dilshan/6ch-speaker-selector/readme.md

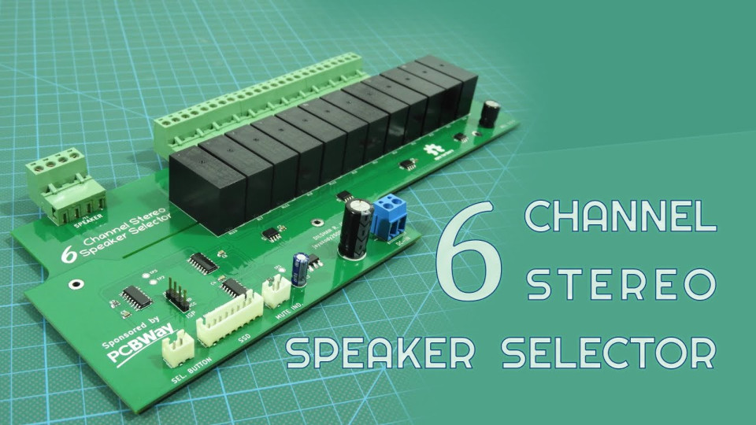
[picture p1: resources/6ch-speaker-selector-youtube.jpg]
6-channel-speaker-selector video (https://youtu.be/IV8KEQPGEuk)


This project is a DIY six-channel stereo speaker selector based on *[STC15W201](https://www.stcmicro.com/datasheet/STC15W201S_Features.pdf)* MCU. The purpose of this electronic switch is to share a pair of speakers between six stereo audio systems.

To select each speaker channel, we use a couple of 12V DPDT relays. These relays interface to *74HC595* through a *ULN2001D*, 3-channel Darlington transistor array IC. 

The 6-channel speaker selector is an open-source project. This repository has all the schematics, PCB design files, and firmware source codes. 

The complete [documentation](https://github.com/dilshan/6ch-speaker-selector/wiki) of this project is in the [wiki section](https://github.com/dilshan/6ch-speaker-selector/wiki) of this repository. The PCB Gerber files and compiled binaries are also available in the [release section](https://github.com/dilshan/6ch-speaker-selector/releases) of this repository. The PCB of the 6-channel speaker selector can also order from the [PCBWay website](https://www.pcbway.com/project/shareproject/6_channel_stereo_speaker_selector_a32e4deb.html).

This is a [certified open hardware project](https://certification.oshwa.org/lk000013.html) and all the content of this project is distributed under the terms of the following license:

- Hardware License: [CERN-OHL-W 2.0](https://ohwr.org/cern_ohl_w_v2.txt)
- Software License: [MIT](https://github.com/dilshan/6ch-speaker-selector/blob/main/LICENSE)
- [Documentation](https://github.com/dilshan/6ch-speaker-selector/wiki) License: [CC BY 4.0](https://creativecommons.org/licenses/by/4.0/)
