dilshan/6ch-speaker-selector/design/speaker-selector-v2.ods

Ref | Qnty | Value | Cmp name | Footprint | Description | Vendor
C1, | 1 | 470MFD | C_Polarized_US | Capacitor_THT:CP_Radial_D10.0mm_P5.00mm | Polarized capacitor, US symbol
C2, | 1 | 10MFD | C_Polarized_US | Capacitor_THT:CP_Radial_D5.0mm_P2.00mm | Polarized capacitor, US symbol
C3, | 1 | 0.22MFD | C | Capacitor_SMD:C_0805_2012Metric_Pad1.18x1.45mm_HandSolder | Unpolarized capacitor
C4, C5, C6, C7, C9, | 5 | 0.1MFD | C | Capacitor_SMD:C_0805_2012Metric_Pad1.18x1.45mm_HandSolder | Unpolarized capacitor
C8, | 1 | 100MFD | C_Polarized_US | Capacitor_THT:CP_Radial_D6.3mm_P2.50mm | Polarized capacitor, US symbol
H1, H2, H3, H4, | 4 | M3 | MountingHole_Pad | MountingHole:MountingHole_2.5mm_Pad | Mounting Hole with connection
H5, | 1 | LOGO | MountingHole | LOGO:6ch-sss | Mounting Hole without connection
H6, | 1 | LOGO | MountingHole | LOGO:pcbway | Mounting Hole without connection
H7, | 1 | LOGO | MountingHole | Symbol:OSHW-Logo2_14.6x12mm_SilkScreen | Mounting Hole without connection
H8, | 1 | LOGO | MountingHole | LOGO:6ch-sss-large | Mounting Hole without connection
J1, | 1 | 5mm x 2-pin | Conn_01x02 | TerminalBlock_Phoenix:TerminalBlock_Phoenix_MKDS-1,5-2_1x02_P5.00mm_Horizontal | Generic connector, single row, 01x02, script generated (kicad-library-utils/schlib/autogen/connector/)
J2, J4, | 2 | 2.54mm x 2-pin | Conn_01x02 | Connector_JST:JST_EH_B2B-EH-A_1x02_P2.50mm_Vertical | Generic connector, single row, 01x02, script generated (kicad-library-utils/schlib/autogen/connector/)
J3, | 1 | 2.54mm x 8-pin | Conn_01x08 | Connector_JST:JST_EH_B8B-EH-A_1x08_P2.50mm_Vertical | Generic connector, single row, 01x08, script generated (kicad-library-utils/schlib/autogen/connector/)
J5, J6, J7, J8, J9, J10, J11, | 7 | 5mm x 4-pin | Conn_01x04 | Connector_Phoenix_MC_HighVoltage:PhoenixContact_MC_1,5_4-G-5.08_1x04_P5.08mm_Horizontal | Generic connector, single row, 01x04, script generated (kicad-library-utils/schlib/autogen/connector/)
J12, | 1 | 2.54mm-4-pin-PCB-PAD | Conn_01x04 | Connector_PinHeader_2.54mm:PinHeader_1x04_P2.54mm_Vertical | Generic connector, single row, 01x04, script generated (kicad-library-utils/schlib/autogen/connector/)
R1, | 1 | 10K | R | Resistor_SMD:R_0805_2012Metric_Pad1.20x1.40mm_HandSolder | Resistor
R2, | 1 | 22K | R | Resistor_SMD:R_0805_2012Metric_Pad1.20x1.40mm_HandSolder | Resistor
RL1, RL2, RL3, RL4, RL5, RL6, RL7, RL8, RL9, RL10, RL11, RL12, | 12 | G2RL-2-DC12 | G2RL-2-DC12 | Relay_THT:Relay_DPDT_Omron_G2RL | General Purpose Relay DPDT (2 Form C) Through Hole, Omron G2RL series, 12V coil
RN1, RN2, | 2 | 620R | R_Pack04_Split | Resistor_SMD:R_Array_Concave_4x0603 | 4 resistor network, parallel topology, split
TP1, TP2, TP3, | 3 | SMD-TP | TestPoint | TestPoint:TestPoint_Pad_D2.0mm | test point
U1, | 1 | LM1117-5.0 | LM1117-5.0 | Package_TO_SOT_SMD:SOT-223-3_TabPin2 | 800mA Low-Dropout Linear Regulator, 5.0V fixed output, TO-220/TO-252/TO-263/SOT-223
U2, | 1 | STC15W201S | STC15W201S | Package_SO:SOP-16_3.9x9.9mm_P1.27mm | Enhanced 8051 MCU
U3, U4, | 2 | 74AHC595 | 74AHC595 | Package_SO:SOP-16_3.9x9.9mm_P1.27mm | 8-bit serial in/out Shift Register 3-State Outputs
U5, U6, U7, U8, | 4 | ULN2001D | ULN2001D | Package_SO:SOP-8_3.9x4.9mm_P1.27mm | 3-CH DARLINGTON SINK DRIVER
