dilshan/6ch-speaker-selector/resources/6ch-speaker-selector-schematic.pdf

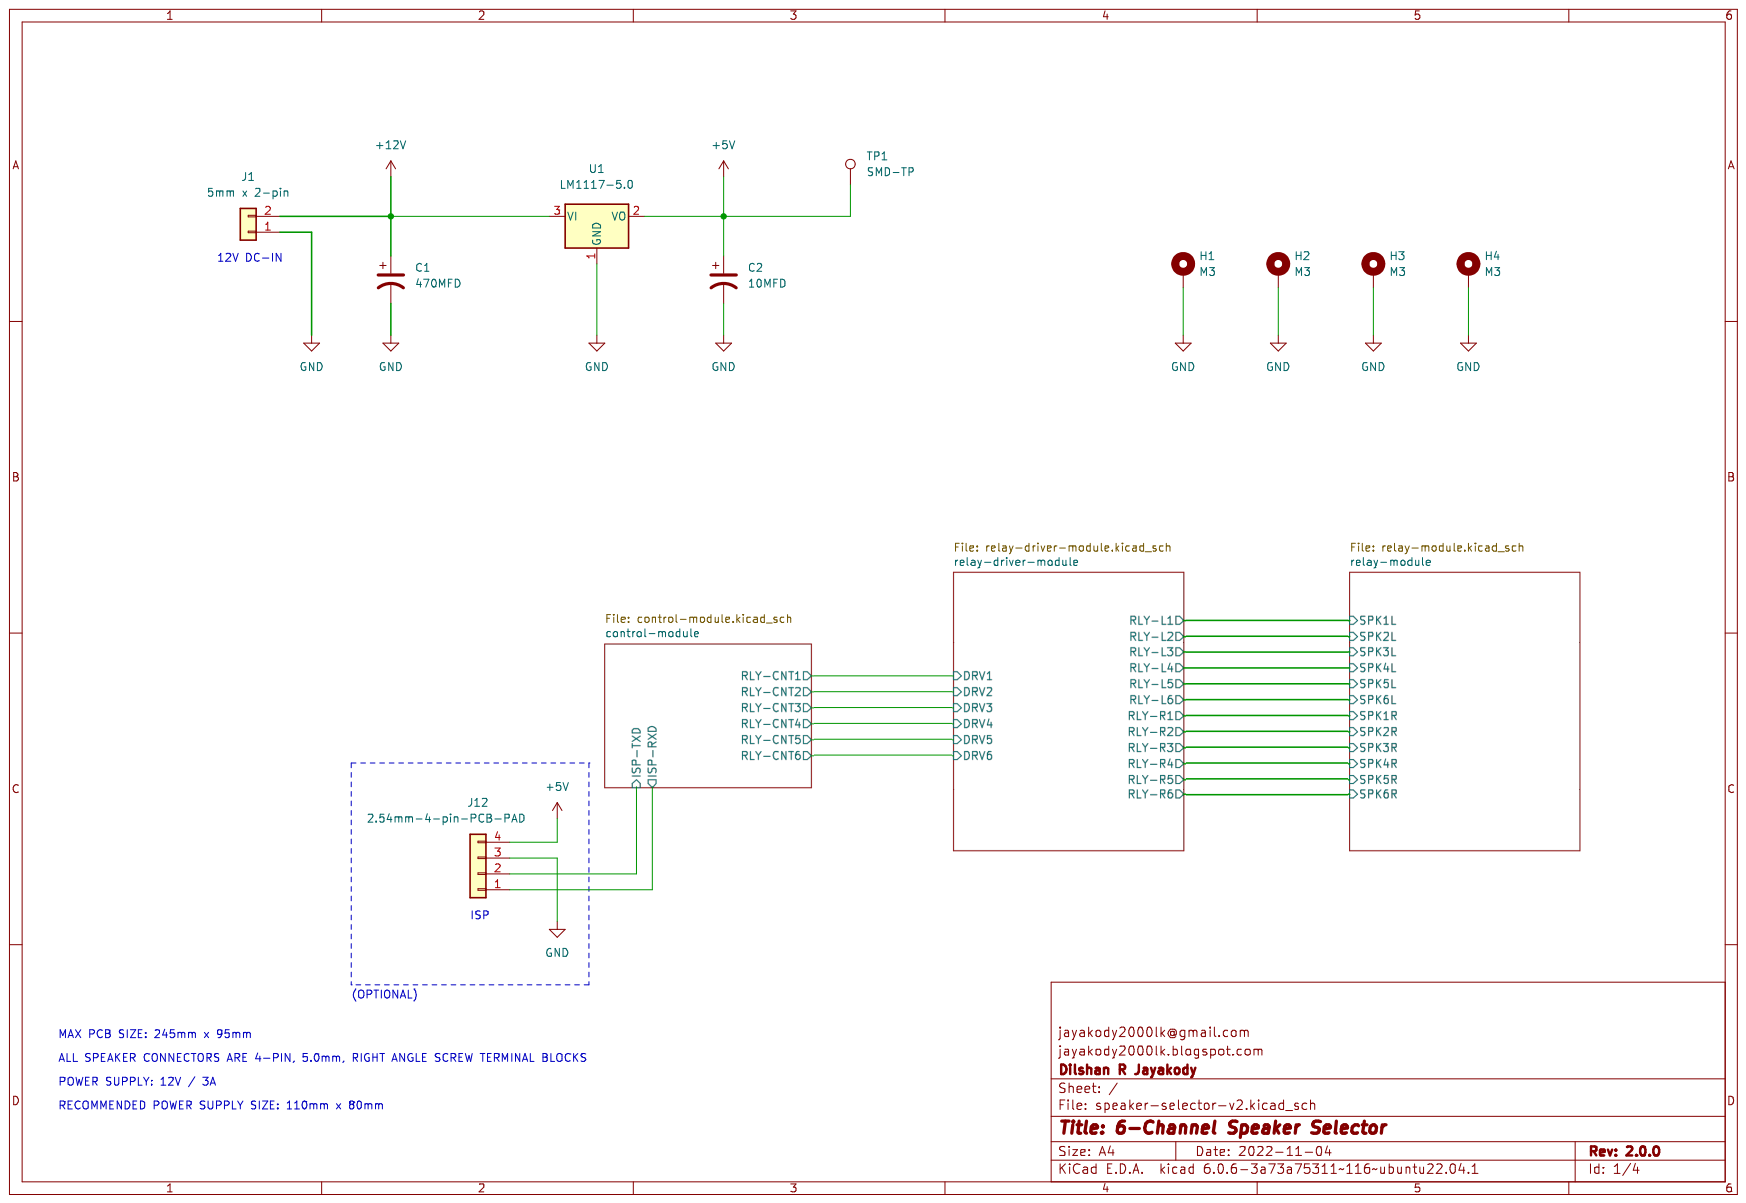
[picture p2: page 1]

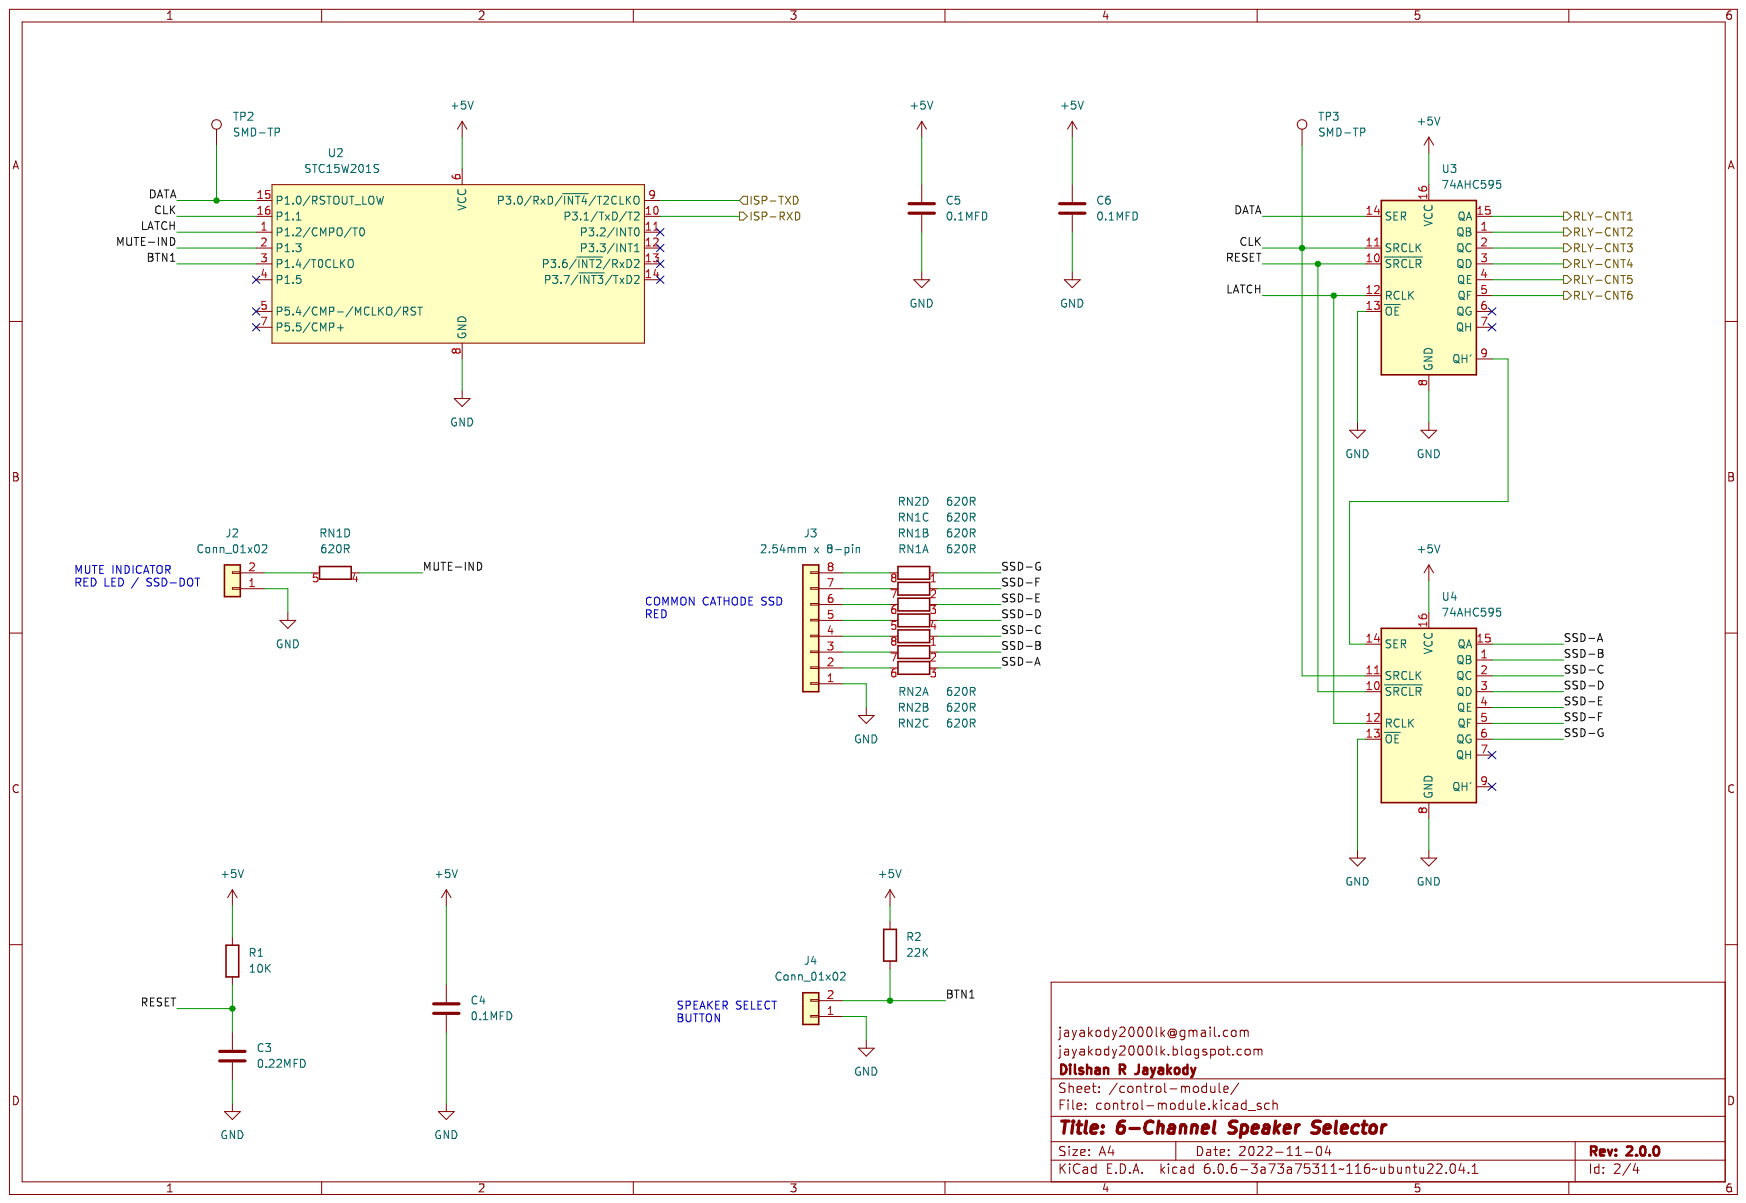
[picture p3: page 2]

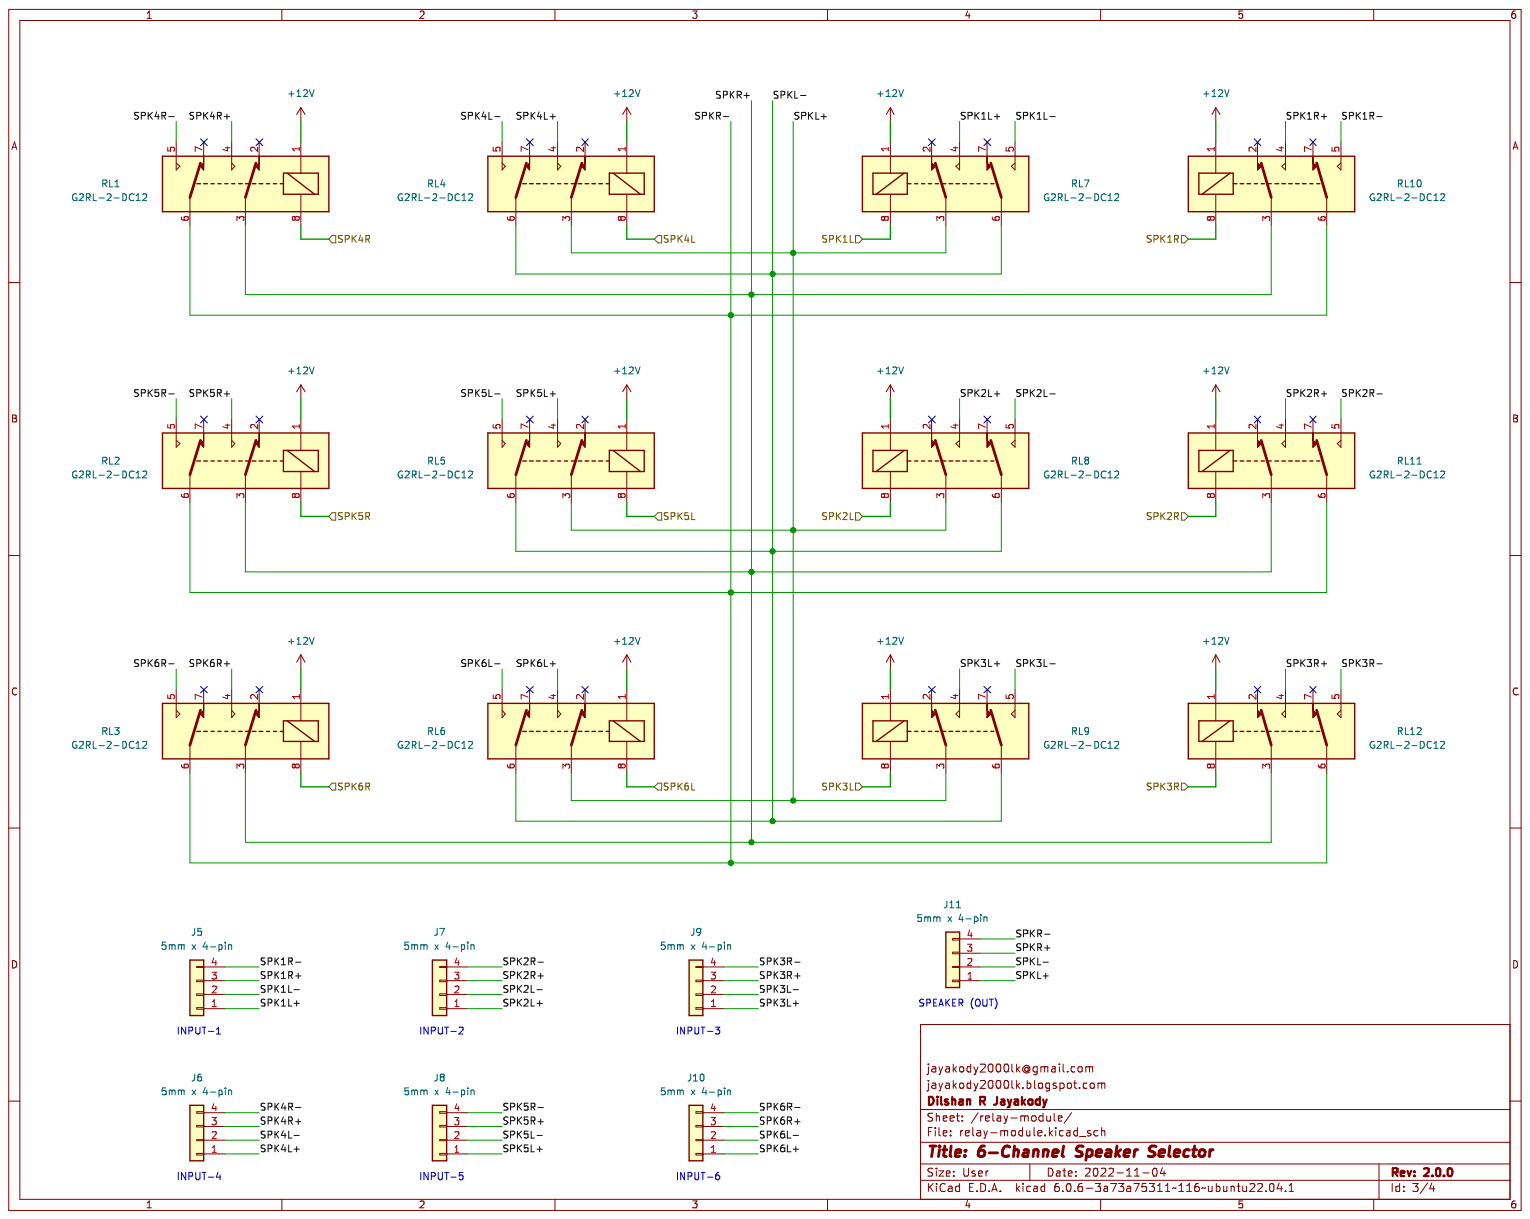
[picture p4: page 3]

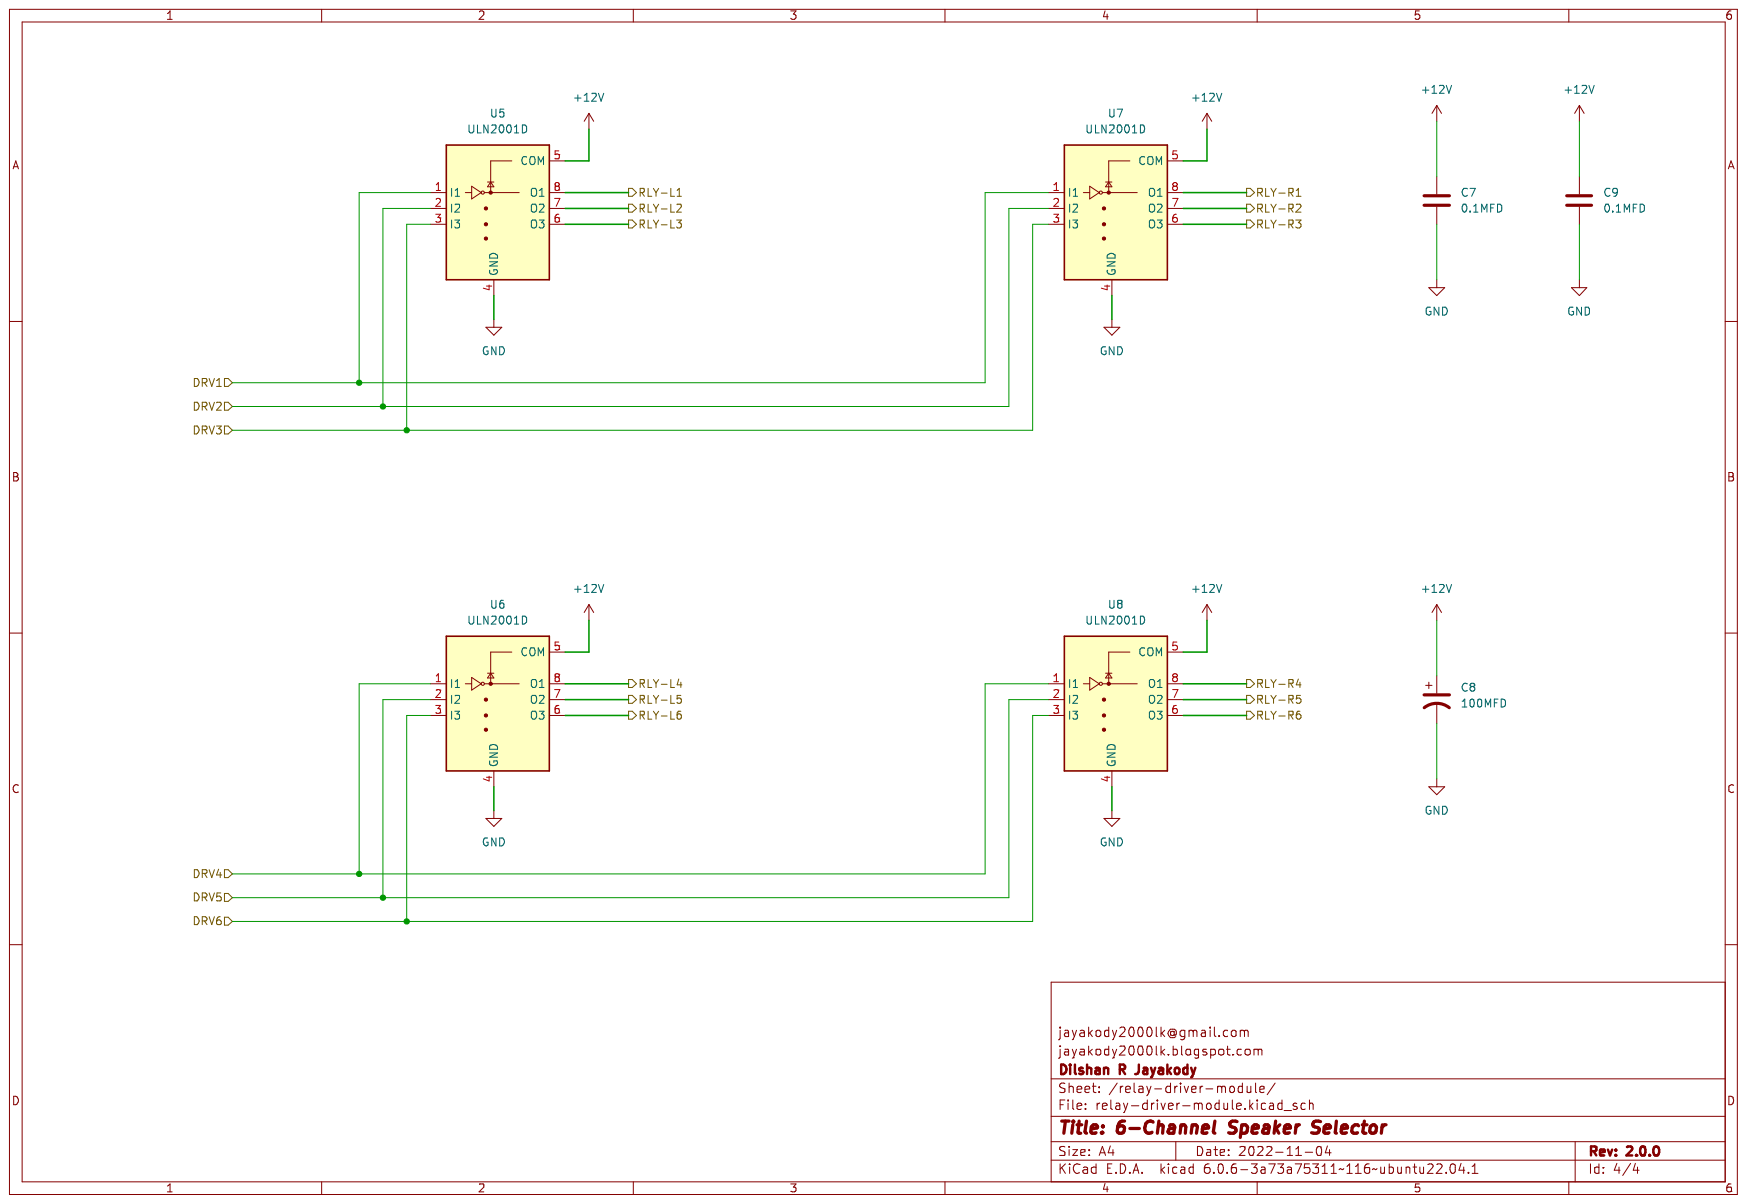
[picture p5: page 4]
