dilshan/6ch-speaker-selector/design/speaker-selector-v2.kicad_pcb

## KiCad design design/speaker-selector-v2.kicad_pcb (2022-12-28)

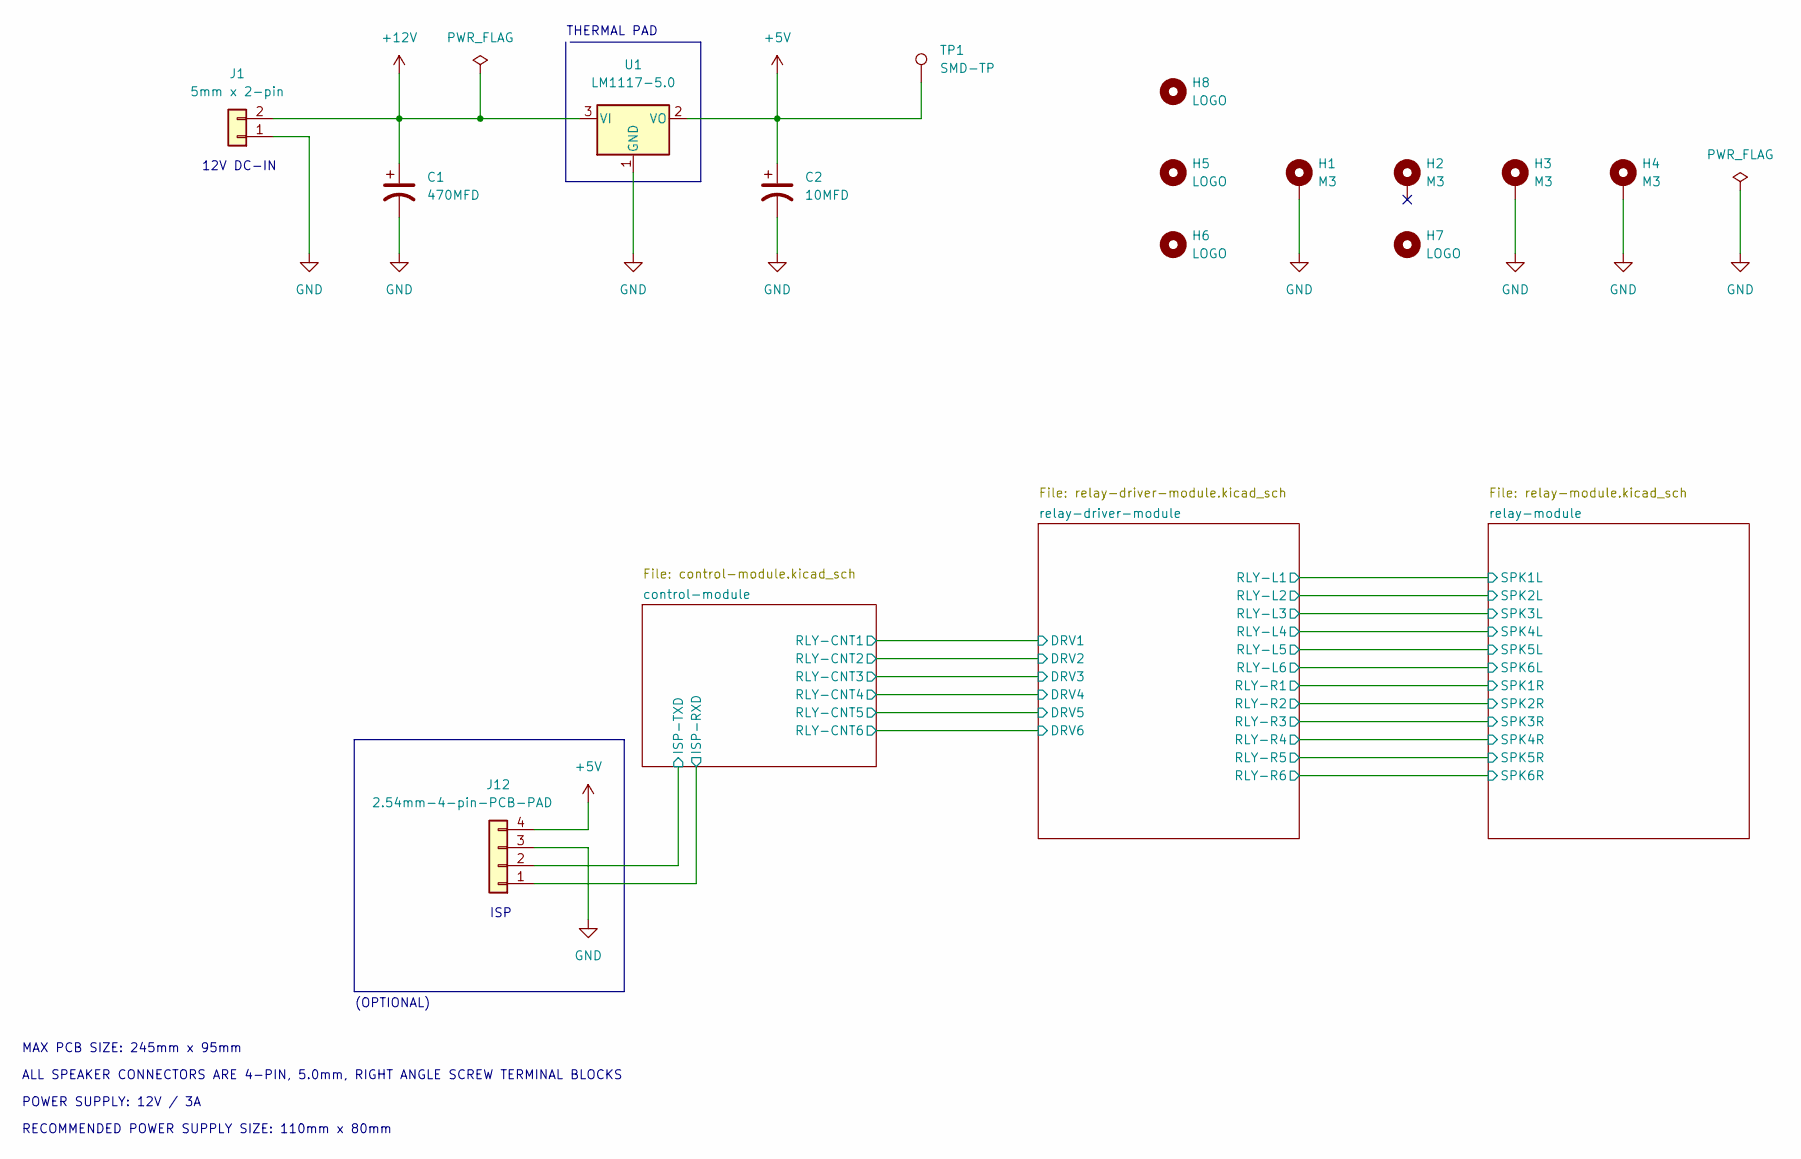
[picture p6: schematic speaker-selector-v2.kicad_sch, 6-Channel Speaker Selector]

Parts:
C1: 470MFD; CP_Radial_D10.0mm_P5.00mm
C2: 10MFD; CP_Radial_D5.0mm_P2.00mm
H1, H2, H3, H4: M3; MountingHole_2.5mm_Pad
H5: LOGO; 6ch-sss
H6: LOGO; pcbway
H7: LOGO; OSHW-Logo2_14.6x12mm_SilkScreen
H8: LOGO; 6ch-sss-large
J1: 5mm x 2-pin; TerminalBlock_Phoenix_MKDS-1,5-2_1x02_P5.00mm_Horizontal
J12: 2.54mm-4-pin-PCB-PAD; PinHeader_1x04_P2.54mm_Vertical
TP1: SMD-TP; TestPoint_Pad_D2.0mm
U1: LM1117-5.0; SOT-223-3_TabPin2

Connections:
+5V: C2.1, J12.4, TP1.1, U1.2 (VO); also elsewhere on the board
+12V: C1.1, J1.2, U1.3 (VI); also elsewhere on the board
/control-module/ISP-RXD: J12.1; also elsewhere on the board
/control-module/ISP-TXD: J12.2; also elsewhere on the board
GND: C1.2, C2.2, H1.1, H3.1, H4.1, J1.1, J12.3, U1.1 (GND); also elsewhere on the board

Notes on the sheet:
(OPTIONAL)
POWER SUPPLY: 12V / 3A
12V DC-IN
ISP
RECOMMENDED POWER SUPPLY SIZE: 110mm x 80mm
THERMAL PAD
ALL SPEAKER CONNECTORS ARE 4-PIN, 5.0mm, RIGHT ANGLE SCREW TERMINAL BLOCKS
MAX PCB SIZE: 245mm x 95mm

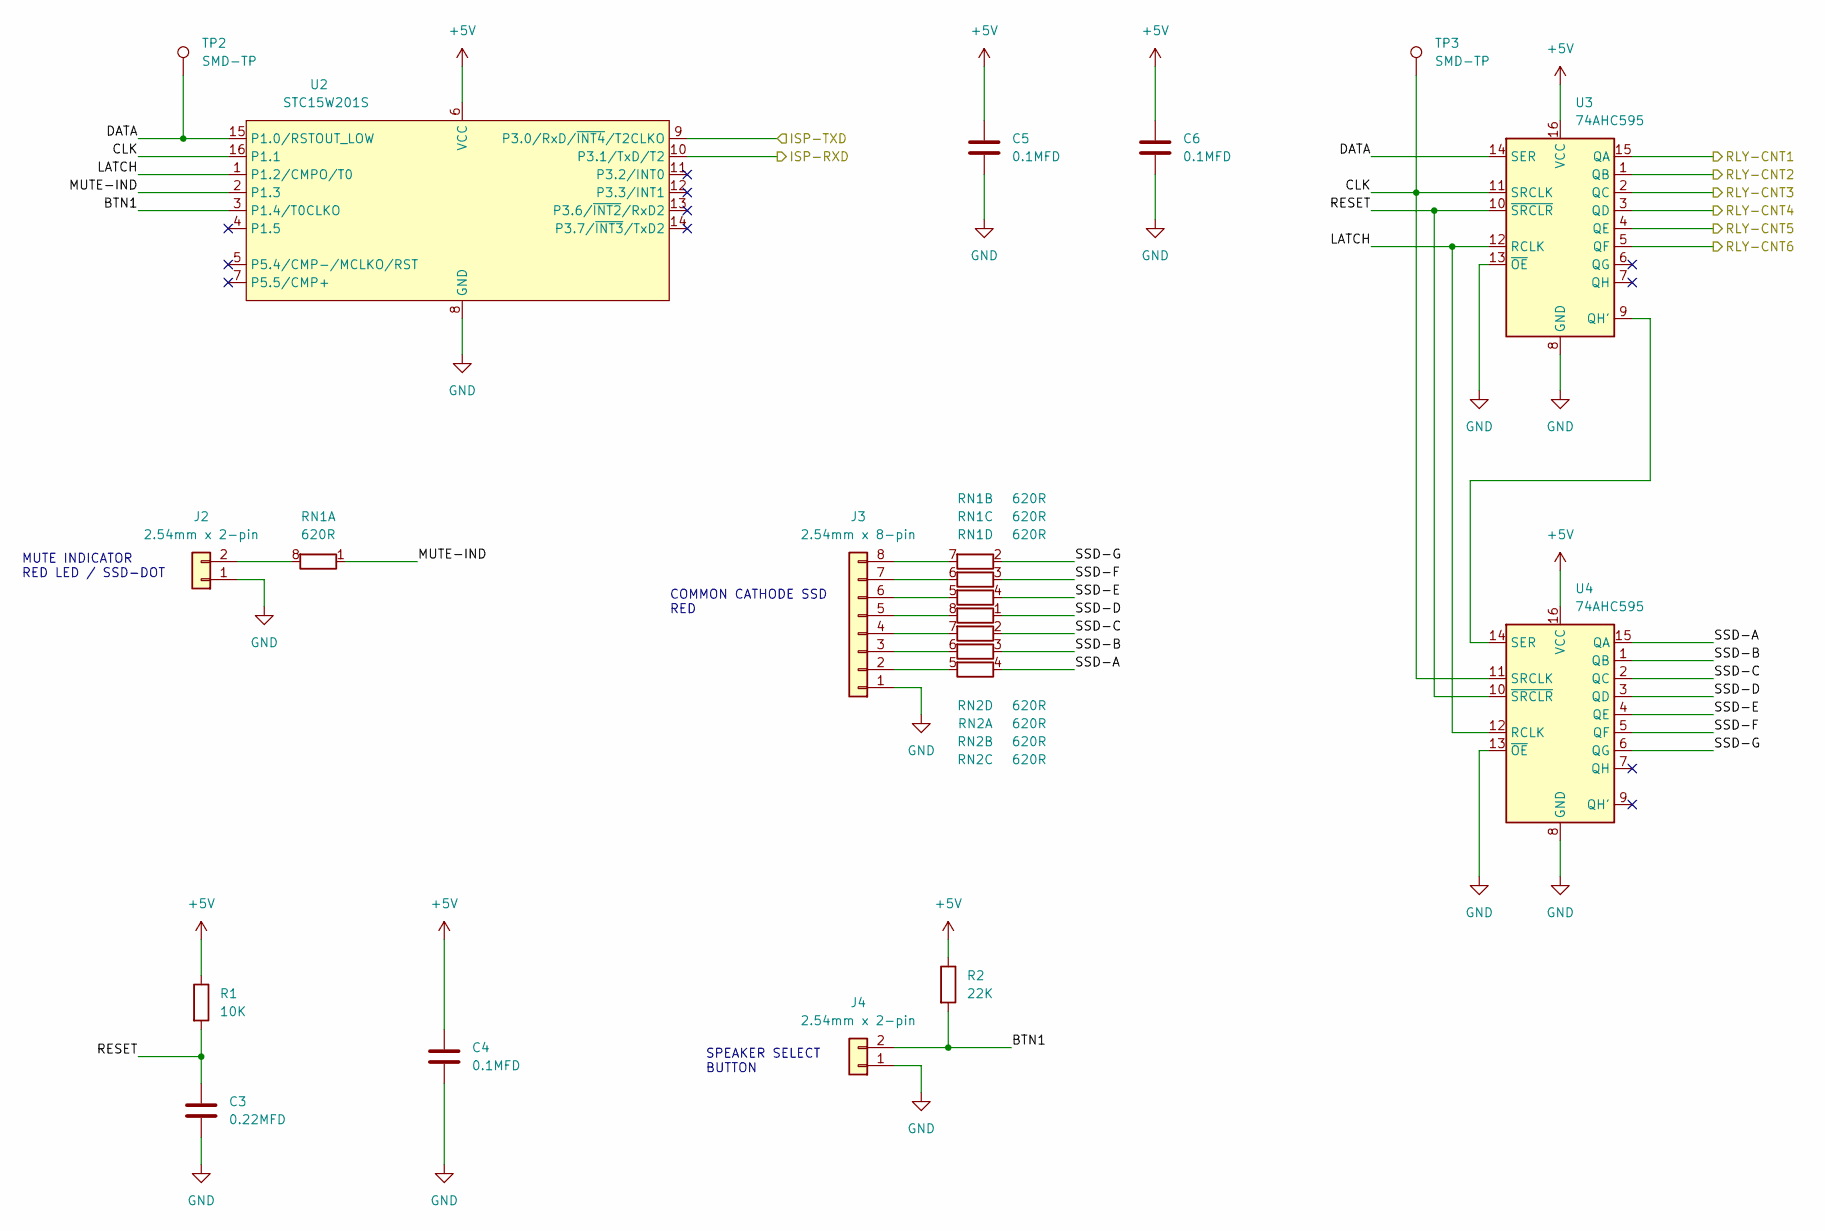
[picture p7: schematic control-module.kicad_sch, 6-Channel Speaker Selector]

Parts:
C3: 0.22MFD; C_0805_2012Metric_Pad1.18x1.45mm_HandSolder
C4, C5, C6: 0.1MFD; C_0805_2012Metric_Pad1.18x1.45mm_HandSolder
J2, J4: 2.54mm x 2-pin; JST_EH_B2B-EH-A_1x02_P2.50mm_Vertical
J3: 2.54mm x 8-pin; JST_EH_B8B-EH-A_1x08_P2.50mm_Vertical
R1: 10K; R_0805_2012Metric_Pad1.20x1.40mm_HandSolder
R2: 22K; R_0805_2012Metric_Pad1.20x1.40mm_HandSolder
RN1, RN2: 620R; R_Array_Concave_4x0603
TP2, TP3: SMD-TP; TestPoint_Pad_D2.0mm
U2: STC15W201S; SOP-16_3.9x9.9mm_P1.27mm
U3, U4: 74AHC595; SOP-16_3.9x9.9mm_P1.27mm

Connections:
+5V: C4.1, C5.1, C6.1, R1.1, R2.1, U2.6 (VCC), U3.16 (VCC), U4.16 (VCC); also elsewhere on the board
/control-module/BTN1: J4.2, R2.2, U2.3 (P1.4/T0CLKO)
/control-module/CLK: TP3.1, U2.16 (P1.1), U3.11 (SRCLK), U4.11 (SRCLK)
/control-module/DATA: TP2.1, U2.15 (P1.0/RSTOUT_LOW), U3.14 (SER)
/control-module/ISP-RXD: U2.10 (P3.1/TxD/T2); also elsewhere on the board
/control-module/ISP-TXD: U2.9 (P3.0/RxD/~INT4/T2CLKO); also elsewhere on the board
/control-module/LATCH: U2.1 (P1.2/CMPO/T0), U3.12 (RCLK), U4.12 (RCLK)
/control-module/MUTE-IND: RN1.1 (R1.1), U2.2 (P1.3)
/control-module/RESET: C3.1, R1.2, U3.10 (~SRCLR), U4.10 (~SRCLR)
/control-module/RLY-CNT1: U3.15 (QA); also elsewhere on the board
/control-module/RLY-CNT2: U3.1 (QB); also elsewhere on the board
/control-module/RLY-CNT3: U3.2 (QC); also elsewhere on the board
/control-module/RLY-CNT4: U3.3 (QD); also elsewhere on the board
/control-module/RLY-CNT5: U3.4 (QE); also elsewhere on the board
/control-module/RLY-CNT6: U3.5 (QF); also elsewhere on the board
/control-module/SSD-A: RN2.4 (R4.1), U4.15 (QA)
/control-module/SSD-B: RN2.3 (R3.1), U4.1 (QB)
/control-module/SSD-C: RN2.2 (R2.1), U4.2 (QC)
/control-module/SSD-D: RN2.1 (R1.1), U4.3 (QD)
/control-module/SSD-E: RN1.4 (R4.1), U4.4 (QE)
/control-module/SSD-F: RN1.3 (R3.1), U4.5 (QF)
/control-module/SSD-G: RN1.2 (R2.1), U4.6 (QG)
GND: C3.2, C4.2, C5.2, C6.2, J2.1, J3.1, J4.1, U2.8 (GND), U3.8 (GND), U3.13 (~OE), U4.8 (GND), U4.13 (~OE); also elsewhere on the board
unnamed: J2.2, RN1.8 (R1.2)
unnamed: J3.2, RN2.5 (R4.2)
unnamed: J3.3, RN2.6 (R3.2)
unnamed: J3.4, RN2.7 (R2.2)
unnamed: J3.5, RN2.8 (R1.2)
unnamed: J3.6, RN1.5 (R4.2)
unnamed: J3.7, RN1.6 (R3.2)
unnamed: J3.8, RN1.7 (R2.2)
unnamed: U3.9 (QH'), U4.14 (SER)

Notes on the sheet:
SPEAKER SELECT BUTTON
MUTE INDICATOR RED LED / SSD-DOT
COMMON CATHODE SSD RED

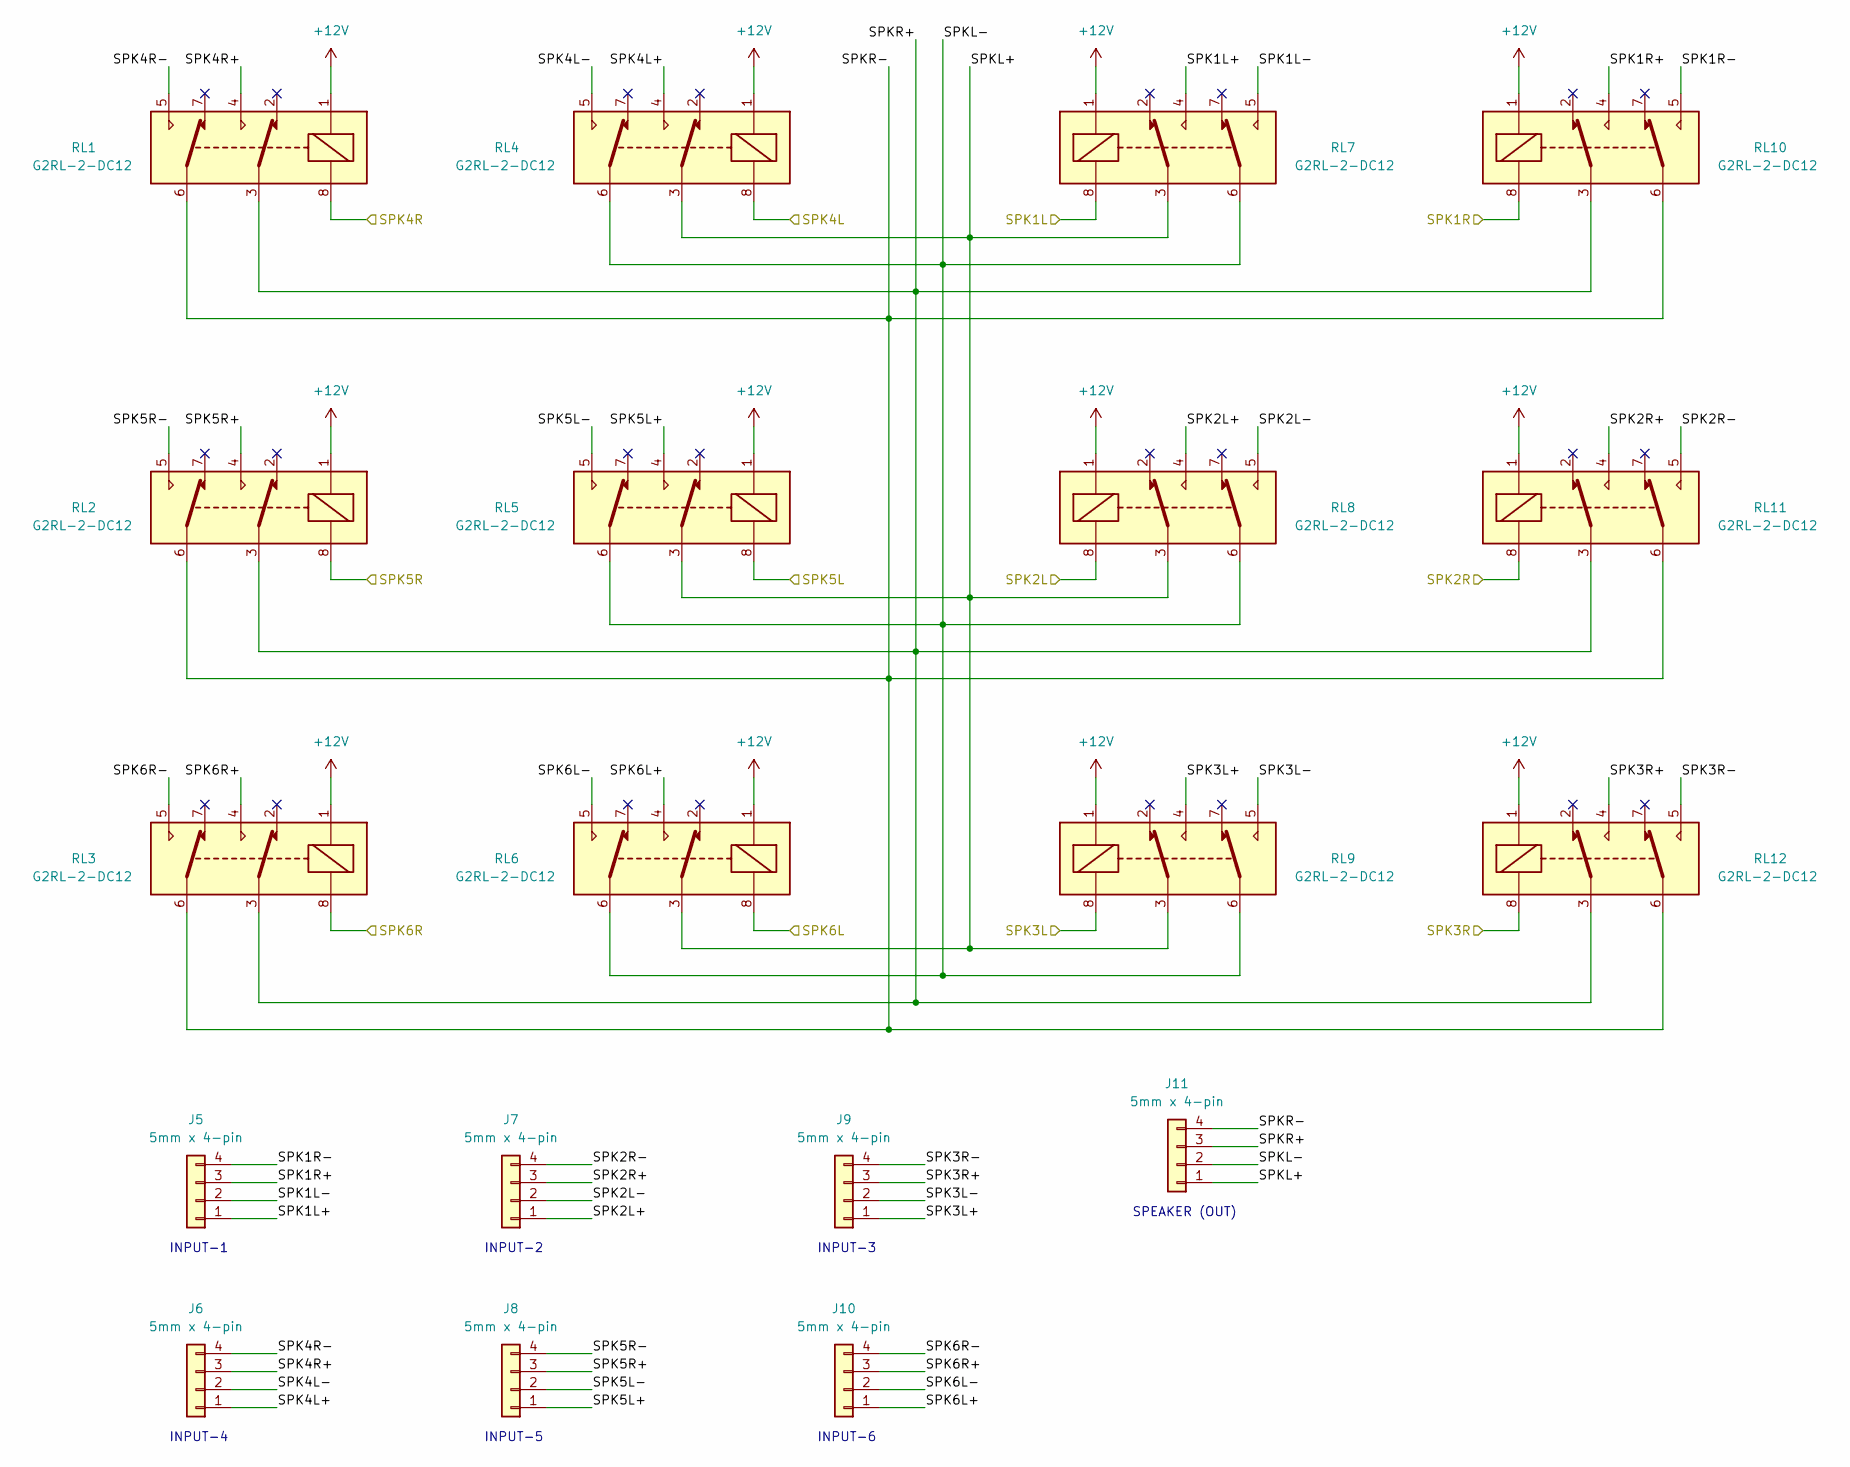
[picture p8: schematic relay-module.kicad_sch, 6-Channel Speaker Selector]

Parts:
J5, J6, J7, J8, J9, J10, J11: 5mm x 4-pin; PhoenixContact_MC_1,5_4-G-5.08_1x04_P5.08mm_Horizontal
RL1, RL2, RL3, RL4, RL5, RL6, RL7, RL8, RL9, RL10, RL11, RL12: G2RL-2-DC12; Relay_DPDT_Omron_G2RL

Connections:
+12V: RL1.1, RL2.1, RL3.1, RL4.1, RL5.1, RL6.1, RL7.1, RL8.1, RL9.1, RL10.1, RL11.1, RL12.1; also elsewhere on the board
/relay-driver-module/RLY-L1: RL7.8; also elsewhere on the board
/relay-driver-module/RLY-L2: RL8.8; also elsewhere on the board
/relay-driver-module/RLY-L3: RL9.8; also elsewhere on the board
/relay-driver-module/RLY-L4: RL4.8; also elsewhere on the board
/relay-driver-module/RLY-L5: RL5.8; also elsewhere on the board
/relay-driver-module/RLY-L6: RL6.8; also elsewhere on the board
/relay-driver-module/RLY-R1: RL10.8; also elsewhere on the board
/relay-driver-module/RLY-R2: RL11.8; also elsewhere on the board
/relay-driver-module/RLY-R3: RL12.8; also elsewhere on the board
/relay-driver-module/RLY-R4: RL1.8; also elsewhere on the board
/relay-driver-module/RLY-R5: RL2.8; also elsewhere on the board
/relay-driver-module/RLY-R6: RL3.8; also elsewhere on the board
/relay-module/SPK1L+: J5.1, RL7.4
/relay-module/SPK1L-: J5.2, RL7.5
/relay-module/SPK1R+: J5.3, RL10.4
/relay-module/SPK1R-: J5.4, RL10.5
/relay-module/SPK2L+: J7.1, RL8.4
/relay-module/SPK2L-: J7.2, RL8.5
/relay-module/SPK2R+: J7.3, RL11.4
/relay-module/SPK2R-: J7.4, RL11.5
/relay-module/SPK3L+: J9.1, RL9.4
/relay-module/SPK3L-: J9.2, RL9.5
/relay-module/SPK3R+: J9.3, RL12.4
/relay-module/SPK3R-: J9.4, RL12.5
/relay-module/SPK4L+: J6.1, RL4.4
/relay-module/SPK4L-: J6.2, RL4.5
/relay-module/SPK4R+: J6.3, RL1.4
/relay-module/SPK4R-: J6.4, RL1.5
/relay-module/SPK5L+: J8.1, RL5.4
/relay-module/SPK5L-: J8.2, RL5.5
/relay-module/SPK5R+: J8.3, RL2.4
/relay-module/SPK5R-: J8.4, RL2.5
/relay-module/SPK6L+: J10.1, RL6.4
/relay-module/SPK6L-: J10.2, RL6.5
/relay-module/SPK6R+: J10.3, RL3.4
/relay-module/SPK6R-: J10.4, RL3.5
/relay-module/SPKL+: J11.1, RL4.3, RL5.3, RL6.3, RL7.3, RL8.3, RL9.3
/relay-module/SPKL-: J11.2, RL4.6, RL5.6, RL6.6, RL7.6, RL8.6, RL9.6
/relay-module/SPKR+: J11.3, RL1.3, RL2.3, RL3.3, RL10.3, RL11.3, RL12.3
/relay-module/SPKR-: J11.4, RL1.6, RL2.6, RL3.6, RL10.6, RL11.6, RL12.6

Notes on the sheet:
INPUT-4
INPUT-6
INPUT-2
INPUT-3
INPUT-1
SPEAKER (OUT)
INPUT-5

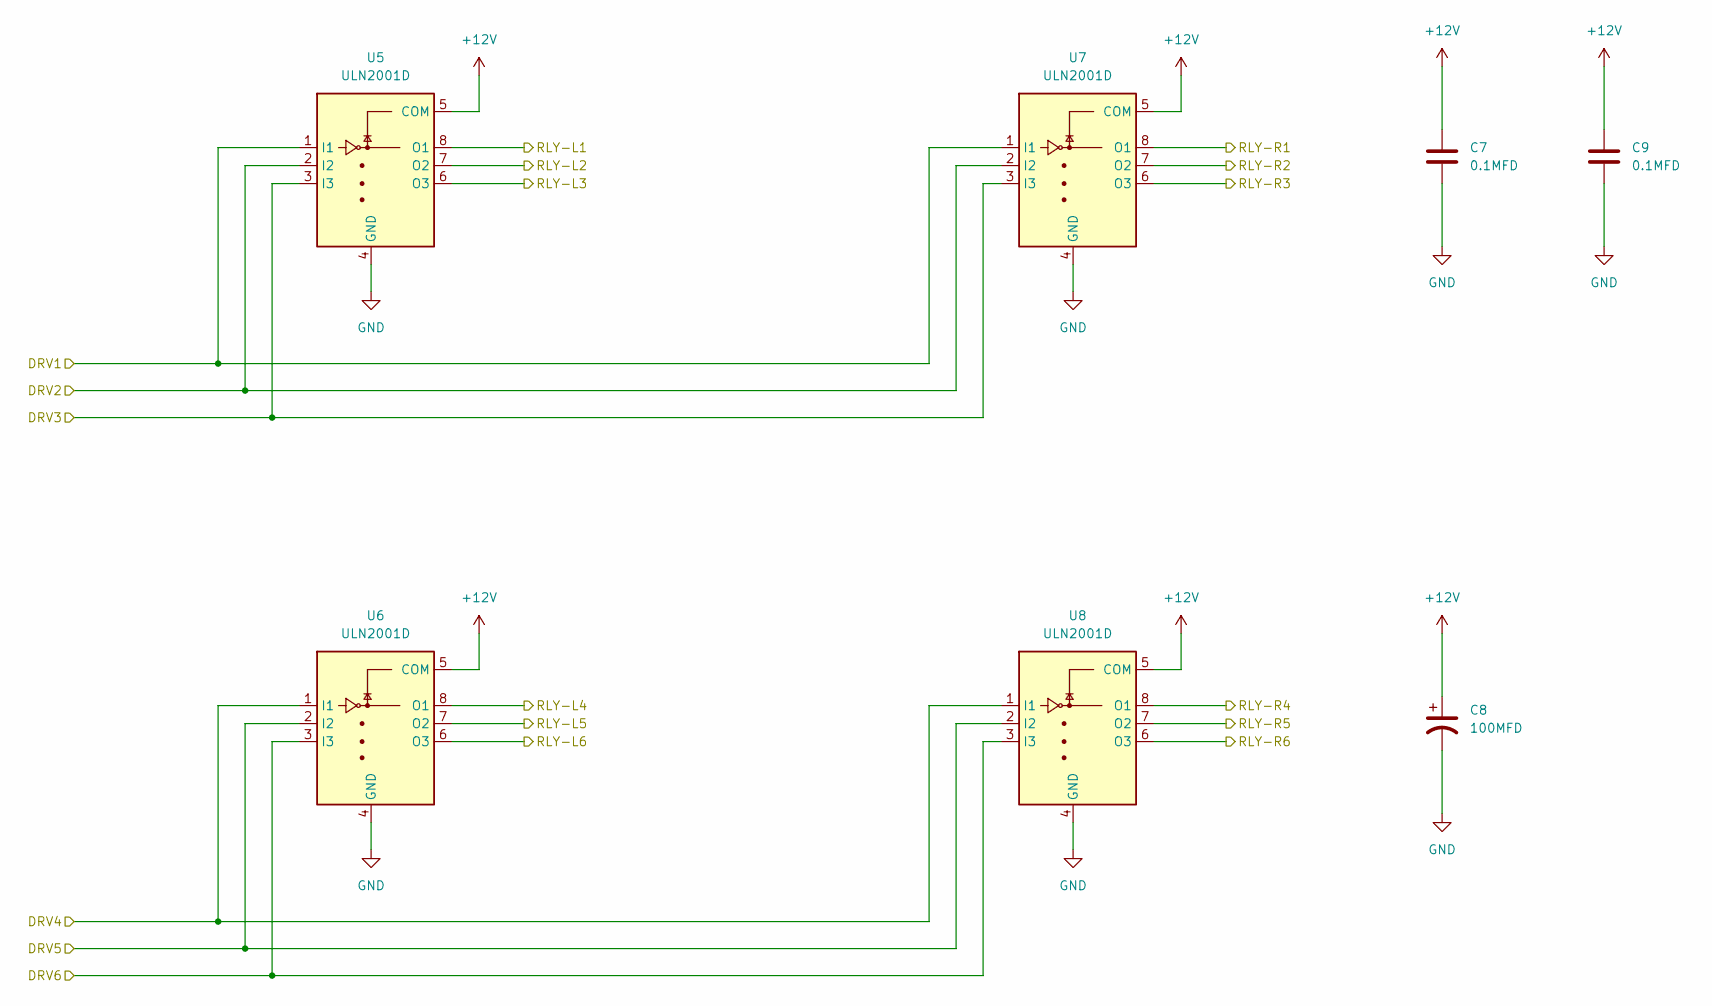
[picture p9: schematic relay-driver-module.kicad_sch, 6-Channel Speaker Selector]

Parts:
C7, C9: 0.1MFD; C_0805_2012Metric_Pad1.18x1.45mm_HandSolder
C8: 100MFD; CP_Radial_D6.3mm_P2.50mm
U5, U6, U7, U8: ULN2001D; SOP-8_3.9x4.9mm_P1.27mm

Connections:
+12V: C7.1, C8.1, C9.1, U5.5 (COM), U6.5 (COM), U7.5 (COM), U8.5 (COM); also elsewhere on the board
/control-module/RLY-CNT1: U5.1 (I1), U7.1 (I1); also elsewhere on the board
/control-module/RLY-CNT2: U5.2 (I2), U7.2 (I2); also elsewhere on the board
/control-module/RLY-CNT3: U5.3 (I3), U7.3 (I3); also elsewhere on the board
/control-module/RLY-CNT4: U6.1 (I1), U8.1 (I1); also elsewhere on the board
/control-module/RLY-CNT5: U6.2 (I2), U8.2 (I2); also elsewhere on the board
/control-module/RLY-CNT6: U6.3 (I3), U8.3 (I3); also elsewhere on the board
/relay-driver-module/RLY-L1: U5.8 (O1); also elsewhere on the board
/relay-driver-module/RLY-L2: U5.7 (O2); also elsewhere on the board
/relay-driver-module/RLY-L3: U5.6 (O3); also elsewhere on the board
/relay-driver-module/RLY-L4: U6.8 (O1); also elsewhere on the board
/relay-driver-module/RLY-L5: U6.7 (O2); also elsewhere on the board
/relay-driver-module/RLY-L6: U6.6 (O3); also elsewhere on the board
/relay-driver-module/RLY-R1: U7.8 (O1); also elsewhere on the board
/relay-driver-module/RLY-R2: U7.7 (O2); also elsewhere on the board
/relay-driver-module/RLY-R3: U7.6 (O3); also elsewhere on the board
/relay-driver-module/RLY-R4: U8.8 (O1); also elsewhere on the board
/relay-driver-module/RLY-R5: U8.7 (O2); also elsewhere on the board
/relay-driver-module/RLY-R6: U8.6 (O3); also elsewhere on the board
GND: C7.2, C8.2, C9.2, U5.4 (GND), U6.4 (GND), U7.4 (GND), U8.4 (GND); also elsewhere on the board

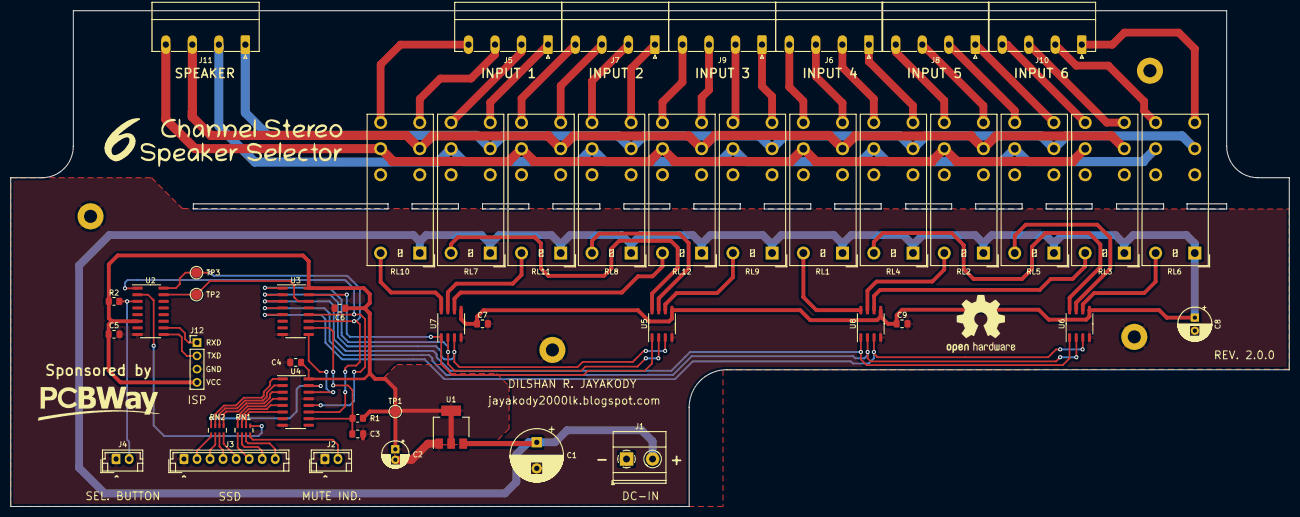
[picture p10: board speaker-selector-v2.kicad_pcb from above]

Board: 2 copper layers, 245.0 x 95.0 mm, 56 parts (1 on the bottom side), 73 nets.
