dilshan/6ch-speaker-selector/resources/wiring-layout/wiring-layout.kicad_sch

## KiCad design resources/wiring-layout/wiring-layout.kicad_sch (2022-12-29)

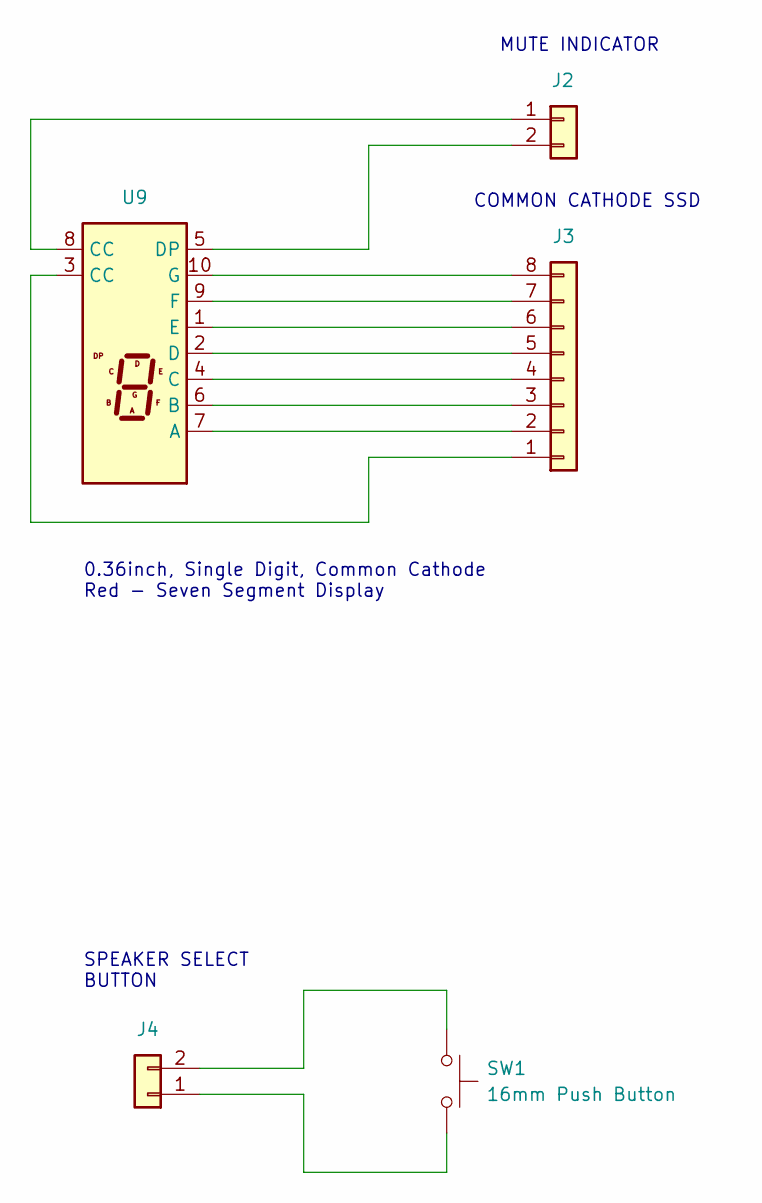
[picture p11: schematic wiring-layout.kicad_sch]

Parts:
J2, J4: Conn_01x02
J3: 2.54mm x 8-pin
SW1: 16mm Push Button
U9: D198K; D1X8K

Connections:
unnamed: J2.1, U9.8 (CC)
unnamed: J2.2, U9.5 (DP)
unnamed: J3.1, U9.3 (CC)
unnamed: J3.2, U9.7 (A)
unnamed: J3.3, U9.6 (B)
unnamed: J3.4, U9.4 (C)
unnamed: J3.5, U9.2 (D)
unnamed: J3.6, U9.1 (E)
unnamed: J3.7, U9.9 (F)
unnamed: J3.8, U9.10 (G)
unnamed: J4.1, SW1.2
unnamed: J4.2, SW1.1

Notes on the sheet:
SPEAKER SELECT BUTTON
COMMON CATHODE SSD
MUTE INDICATOR
0.36inch, Single Digit, Common Cathode Red - Seven Segment Display
