dilshan/6ch-speaker-selector/(commit log)

2022-12-28 Add initial version of design files.
    [control-module.kicad_sch, relay-driver-module.kicad_sch, relay-module.kicad_sch, speaker-selector-v2.kicad_pcb, speaker-selector-v2.kicad_sch]
2022-12-29 Add wiring layout project.
    [speaker-selector-v2.ods, wiring-layout.kicad_sch]
2022-12-30 Add PDF version of the schematic diagram.
2022-12-30 Update PCBWay PCB purchase link.
