dilshan/6ch-speaker-selector/(notices)

Notices in the files:
design/speaker-selector-v2.kicad_pcb:
Licensed under CERN-OHL-W 2.0
